lassipau/EEZYbot-MK2-PS2-controller/Board Schematic/Connection-board-schematic.pdf

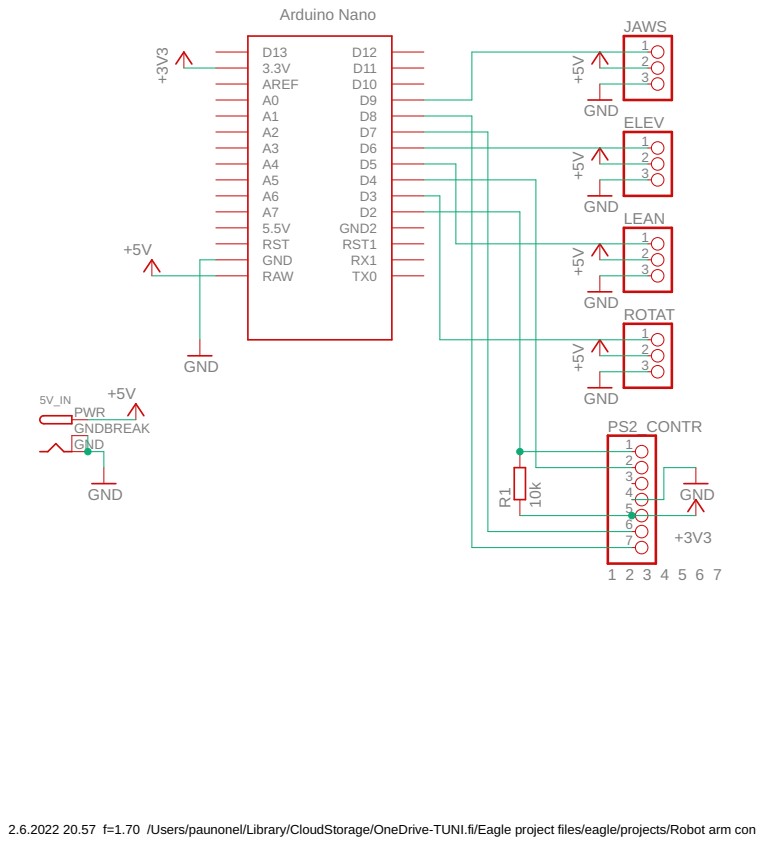
[picture p5: page 1]

2.6.2022 20.57 f=1.70 /Users/paunonel/Library/CloudStorage/OneDrive-TUNI.fi/Eagle project files/eagle/projects/Robot arm connection board/conn-board.sch (Sheet: 1/1)
