lassipau/EEZYbot-MK2-PS2-controller/CHANGELOG.md

# Changelog EEZYbot Robotic Arm with PS2 Controller

The main changes to "EEZYbot Robotic Arm with PS2 Controller" are documented in this file

The format is based on [Keep a Changelog](https://keepachangelog.com/en/1.0.0/)

## [Unreleased]

### Added 

- Connection board schematic (in Board Schematic/Connection-board-schematic.pdf)
- Arduino code for the EEZYbot control.
- Gerber files for the connection PCB.
- This Changelog file.

### Changed

-

### Removed

- 

### Fixed

- 

[unreleased]: https://github.com/lassipau/EEZYbot-MK2-PS2-controller/main
