lassipau/EEZYbot-MK2-PS2-controller/(commit log)

2021-09-12 Updated README with figures and wiring instructions
2022-06-02 Added connection board schematic
